junkbotix/toy-rc-car-robot-platform/README.md

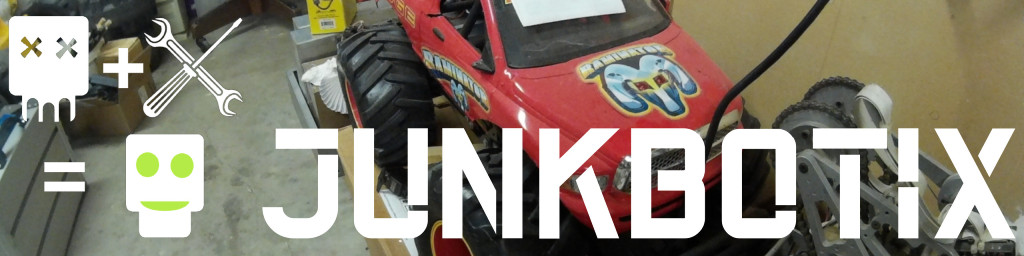
[picture p1: images/banner-1024px.jpg]
Junkbotix Banner


# A Low-Cost Toy RC Car Robot Platform

Check out the latest on this project and tutorial at the [Junkbotix Channel](https://www.youtube.com/channel/UCNxQ47xBEYjD-mey_lxj9Aw) on Youtube!

<br>

## Mechanical

* [Steering](./steering)
* [Notes](./notes)

<br>

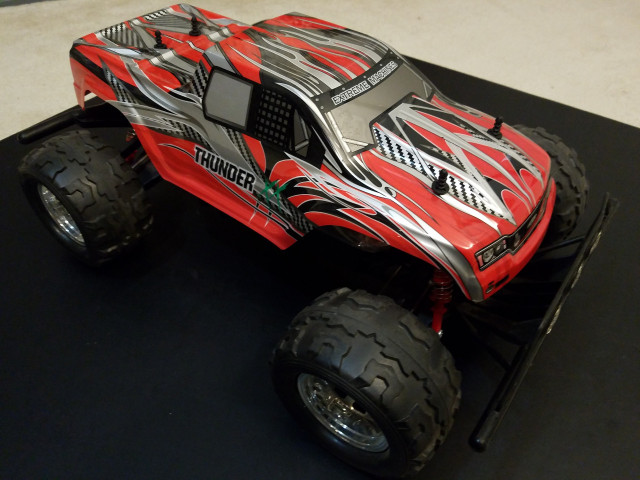
[picture p2: images/vehicle-640px.jpg]
Vehicle
 

## Platform / Deck

* [Fabrication](./platform-deck)
* [Completed Example](./platform-deck/completed)

<br>

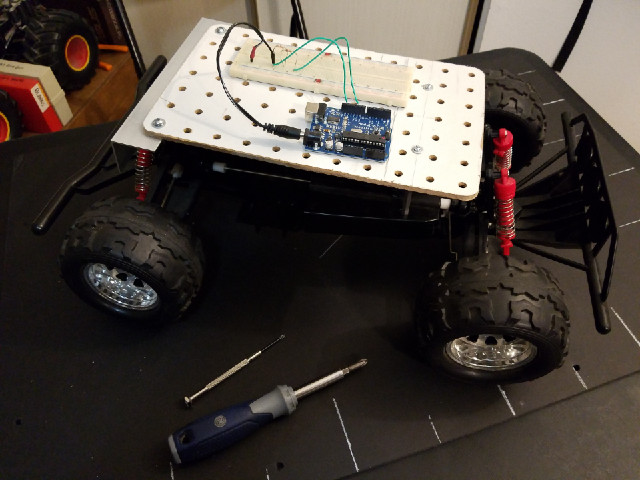
[picture p3: images/deck-640px.jpg]
 

<br>

## Electronics

* [Interfacing](./interfacing)
* [Sensors](./sensors)
* [Datasheets](./datasheets)

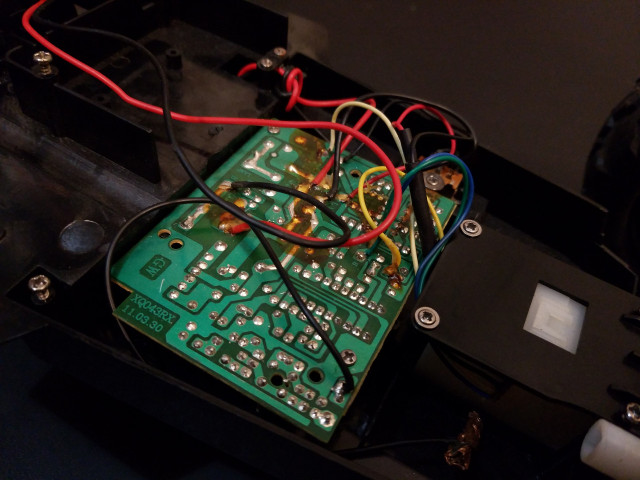
[picture p4: images/pcb-640px.jpg]
PCB


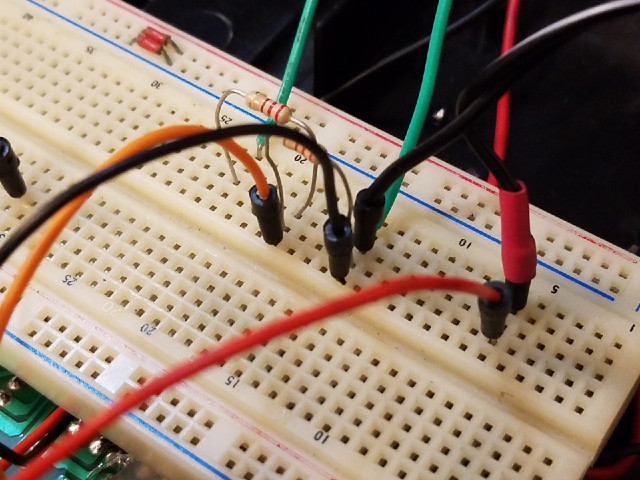
[picture p5: images/interface-640px.jpg]
Breadboard Interface


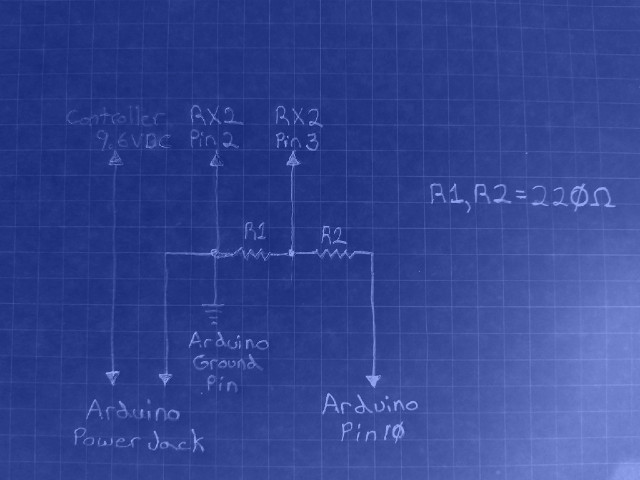
[picture p6: images/schematic-640px.jpg]
Schematic


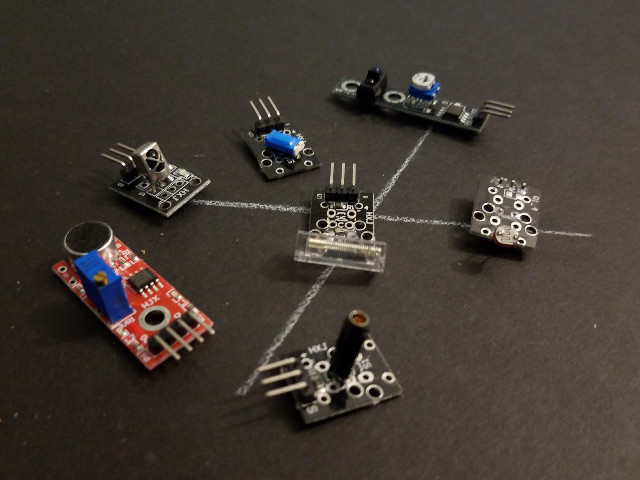
[picture p7: images/sensors-640px.jpg]
Sensors


<br>

## Software

* [Software](./software)
