junkbotix/toy-rc-car-robot-platform/software/README.md

# Software

Here you will find any and all software code, created by Junkbotix, that is related to this tutorial. Be sure to check back often for updates!

[Arduino](./arduino)

## Note

So far, only the Arduino Uno and Duemilanove have been tested and coded for. But just about anything should work (with the proper code written, of course). An interesting idea might involve using an ESP8266 or an ESP32, especially one with a camera board for computer vision experiments!
