junkbotix/toy-rc-car-robot-platform/steering/README.md

# Steering Actuator - A Curious Observation

The steering actuator on this vehicle is very curious in its design, which I have noted in the videos.

Mainly, because in addition to the wires for the motor that controls the actuator, it has four additional wires:

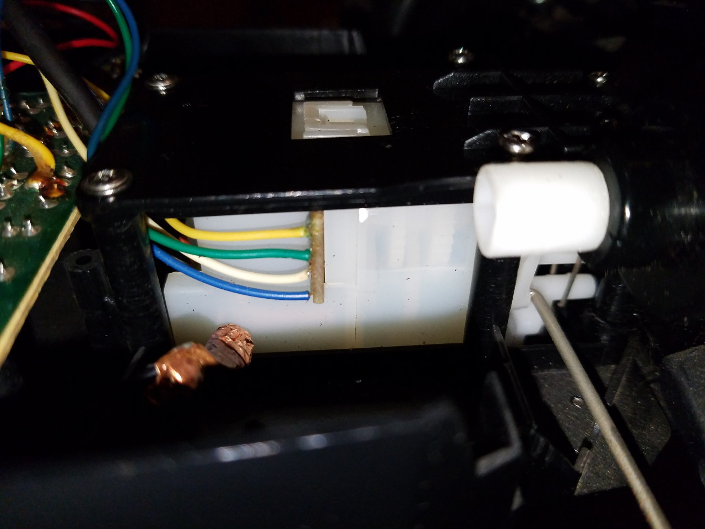
[picture p15: steering/images/actuator.jpg]
Steering Actuator
 

These wires appear to be connected in some manner to the steering actuator's h-bridge:

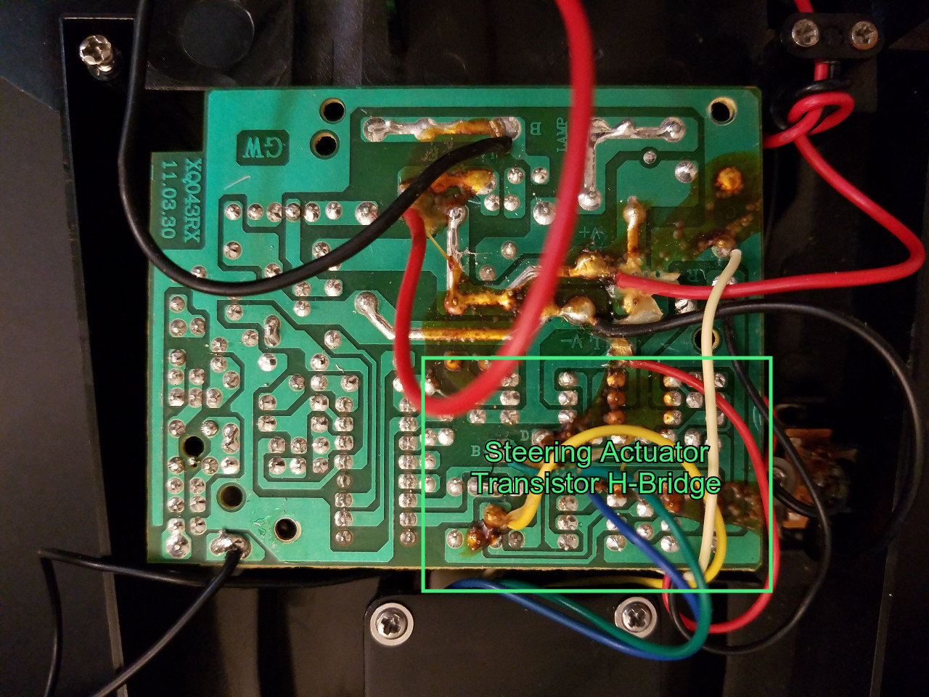
[picture p16: steering/images/pcb-bottom.jpg]
Controller Bottom
 
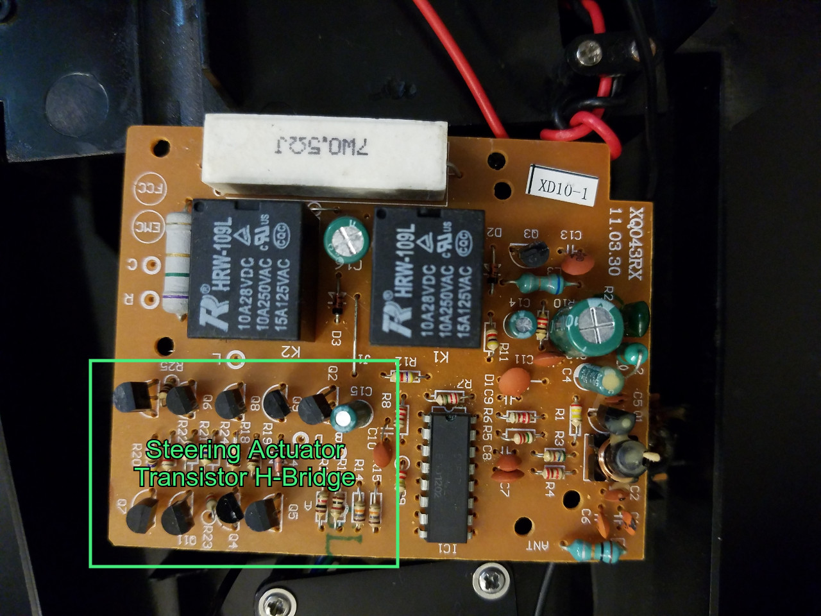
[picture p17: steering/images/pcb-top.jpg]
Controller Top
 

## What makes this strange?

The reason that this is so curious, is that the datasheet for the [SDRX2BD](../datasheets/controller) indicates that the IC only has outputs for left and right steering (pins 6 & 7), and the input pins (8 & 9) for disabling these functions are not hooked up on my car's controller:

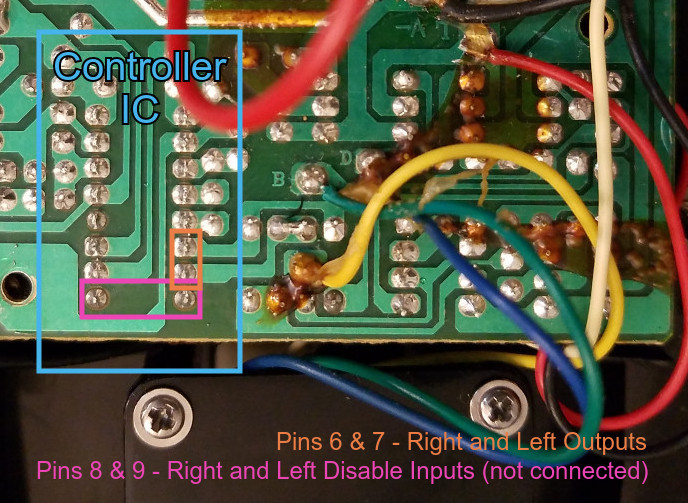
[picture p18: steering/images/pins.jpg]
SDRX2BD Pins


Furthermore, the implementation example schematic in the datasheet doesn't show anything about such functionality:

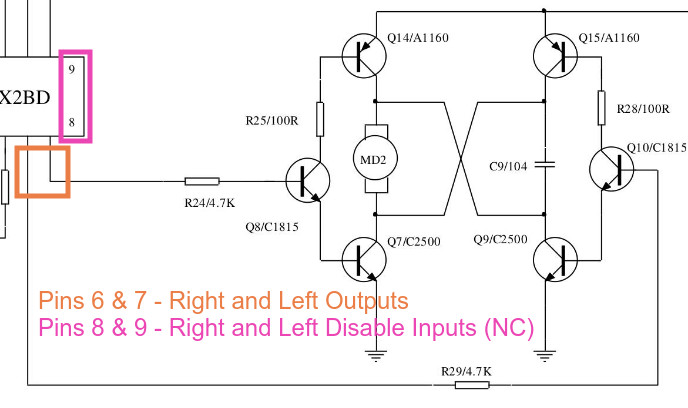
[picture p19: steering/images/schematic.jpg]
Example


As a final note, I have never seen any other toy RC vehicle that used this chipset (the TX2-RX2 and clones) have any kind of connections to the steering actuator other than directly to the motor - in other words, usually just two wires, instead of the "2+4" arrangement we see here.

## My analysis and thoughts

My best guess is that these wires serve in some manner to inhibit or "limit" the h-bridge output, perhaps to prevent it from drawing too much current, or maybe to automatically center it, or something of that nature.

Until I can reverse-engineer a schematic for that section of the controller board (not a trivial task), it may remain a mystery. Further testing of direct control may reveal additional clues, too.

## More thoughts

After doing the fixes to the wiring, adding a battery, and turning it on, I noticed that the vehicle automatically "recentered" the front wheels. I believe this is actually the purpose of the additional wires, a kind of primitive servomechanism system to keep the car going straight when the steering actuator isn't active (being steered left or right). It might be that due to the size of the vehicle (larger than many or most TX2/RX2 chipset RC vehicles), it needed this kind of system to make it drivable at speed. Again, all of this is a guess without an actual schematic. I do find it a fascinating aspect of the platform!
