junkbotix/toy-rc-car-robot-platform/sensors/smartphone/README.md

# Using a Smartphone as a Sensor?

Well - really as a collection of sensors! I mean, how many sensors does a smartphone have? Tons!

But of particular interest for robotics use are the camera(s) and the GPS (and maybe the IMU, too!)...

* [Use Your Android Phone Sensors on the Arduino!](https://www.instructables.com/Use-your-android-phone-sensors-on-the-arduino-/)

Another great example of using a phone in such a manner is David Singleton's Neural Network RC Vehicle:

* [How I built a neural network controlled self-driving (RC) car!](https://blog.singleton.io/nnrccar/)
