junkbotix/toy-rc-car-robot-platform/platform-deck/completed/README.md

# A Completed Pegboard Example

These are photos of the pegboard deck built for the tutorial video series, on the Thunder XX chassis I used.

## Rear Bracket

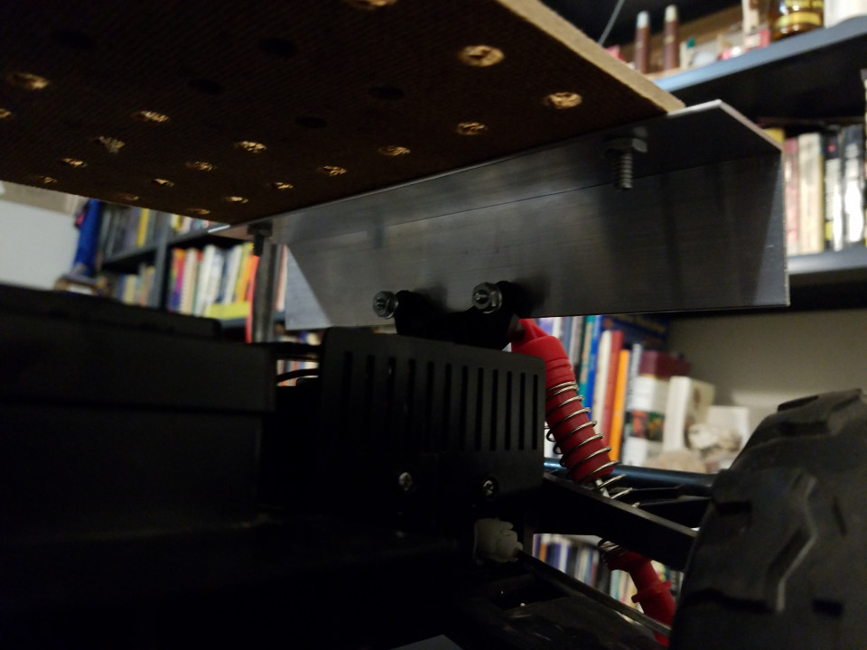
[picture p34: platform-deck/completed/images/rear-bracket-960px.jpg]
Rear Bracket


## Front Standoffs

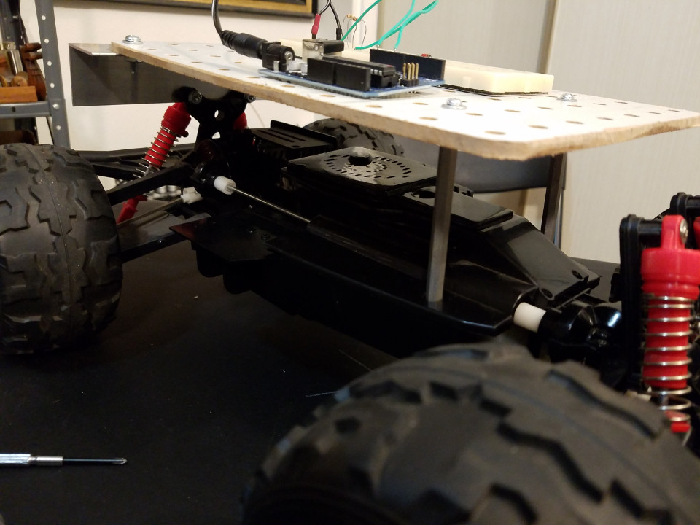
[picture p35: platform-deck/completed/images/front-standoffs-960px.jpg]
Front Standoffs


## Deck

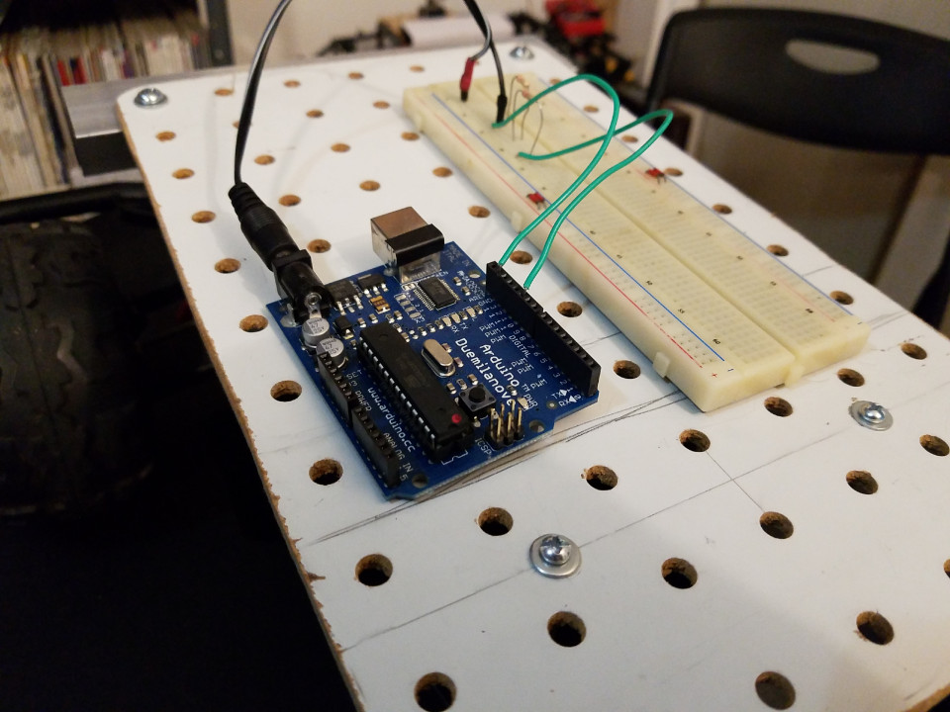
[picture p36: platform-deck/completed/images/deck-example-960px.jpg]
Deck


## Chassis and Deck

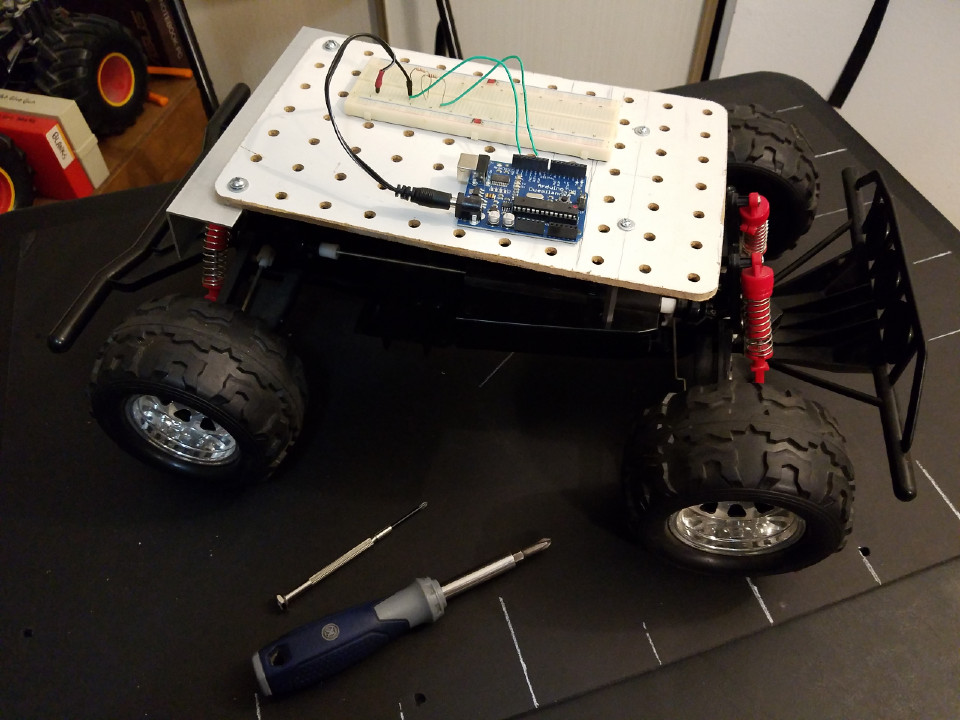
[picture p37: platform-deck/completed/images/chassis-deck-960px.jpg]
Chassis and Deck
