junkbotix/toy-rc-car-robot-platform/interfacing/thunder-xx/backlit-controller.jpg

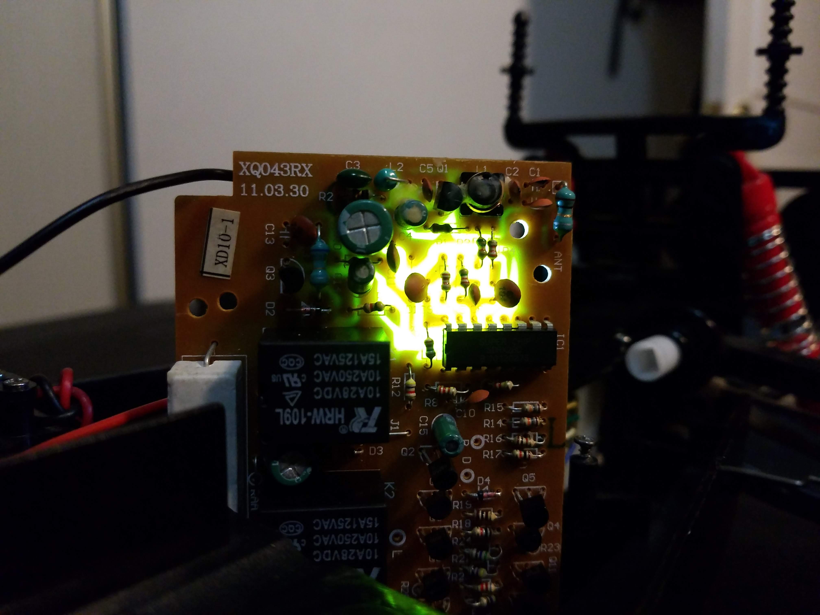
interfacing/thunder-xx/backlit-controller.jpg
