junkbotix/toy-rc-car-robot-platform/interfacing/thunder-xx/hand-drawn-schematic.jpg

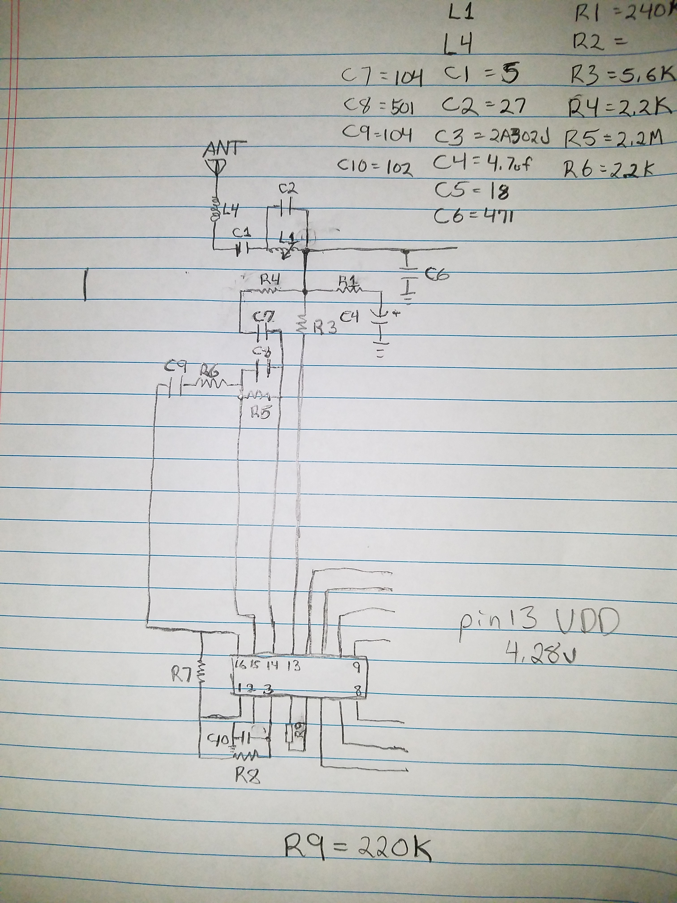
interfacing/thunder-xx/hand-drawn-schematic.jpg
