junkbotix/toy-rc-car-robot-platform/interfacing/thunder-xx/other-notes.jpg

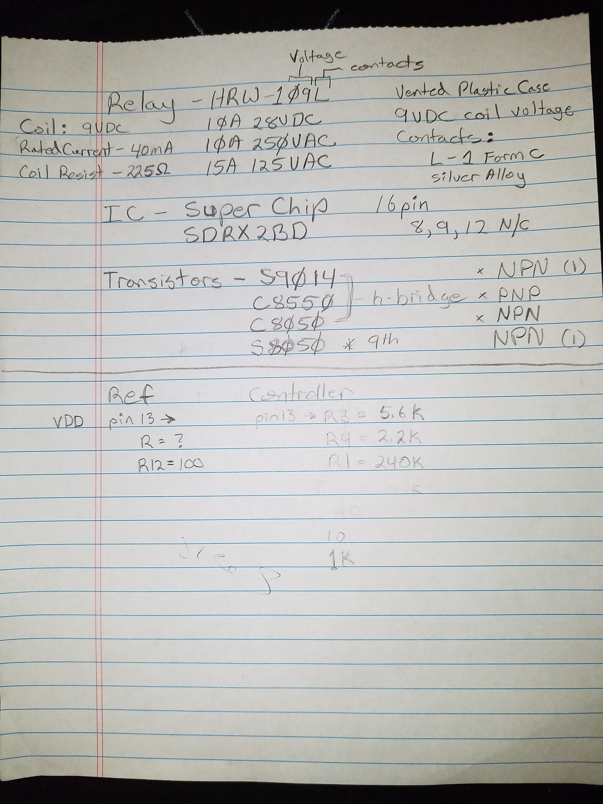
interfacing/thunder-xx/other-notes.jpg
