junkbotix/toy-rc-car-robot-platform/sensors/contact-sensors/images/microswitch-example-640px.jpg

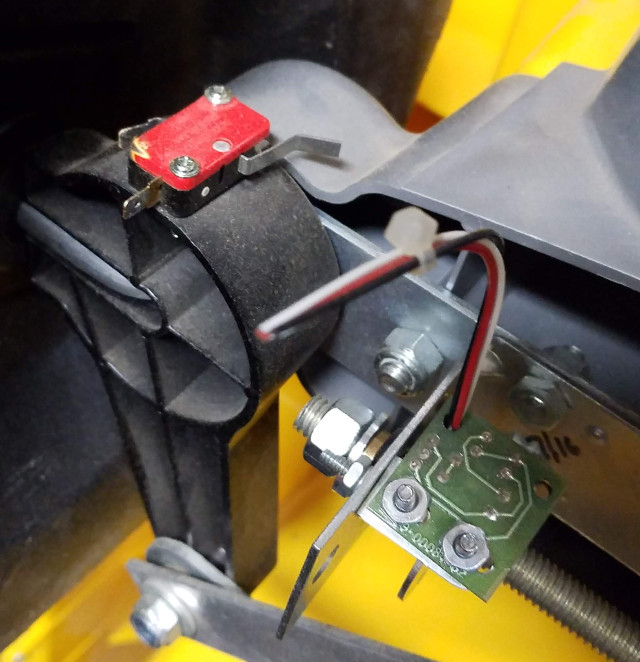
sensors/contact-sensors/images/microswitch-example-640px.jpg
