junkbotix/toy-rc-car-robot-platform/sensors/components/README.md

# Discrete Components

Individual components can be easily ordered from a variety of vendors, way too many to list unfortunately. I will however list some companies here I have had past good experiences with, along with some pictures of some useful discrete sensor components and what they can be used for.

<br>

## New Components

* Digikey - https://www.digikey.com/
* Mouser - https://www.mouser.com/
* Jameco - https://www.jameco.com/

Note: I understand these vendors are USA-centric, but they do ship internationally, and are probably the best way to get new and brand-name components at smaller quantities than you could get through many other sources. I may update this list in the future, if I get suggestions of other similar international sources, or as I find them.

<br>

## NOS (New-Old Stock) and Surplus Components

* All Electronics - https://www.allelectronics.com/
* Electronic Goldmine - https://www.goldmine-elec-products.com/
* Altronics - https://anatekinstruments.com/

Again, the above vendors are USA-centric, and from what I understand, surplus electronics sales tend to be a mostly American thing, as laws in other countries (ymmv) prohibit or severely limit such "recycling". Also, despite being "surplus" outlets, all of the above vendors also sell new components and other new items.

Finally, don't hesitate to look into discrete components from Amazon or Ebay...sometimes you can find interesting stuff there, too!

<br>

## Examples

### Photoresistors (aka LDR, CdS cells, etc)
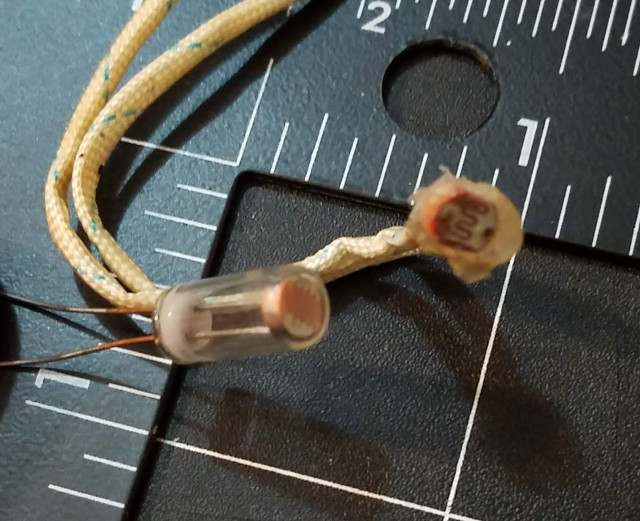
[picture p55: sensors/components/images/photoresistors-640px.jpg]
Photoresistors


### Phototransistors
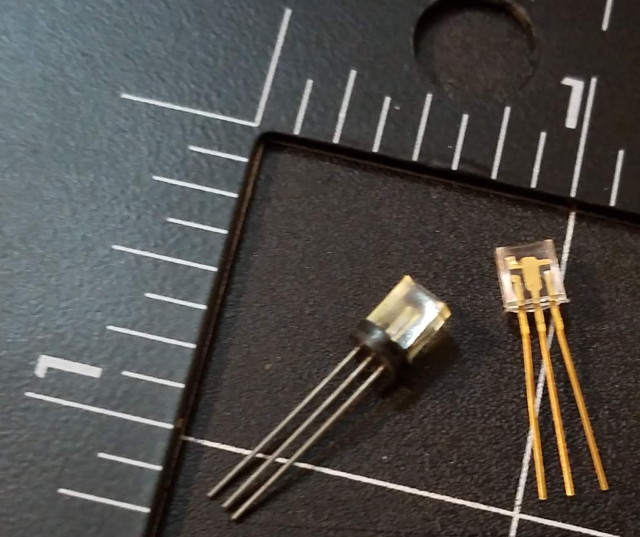
[picture p56: sensors/components/images/phototransistors-640px.jpg]
Phototransistors


### Slot Sensor
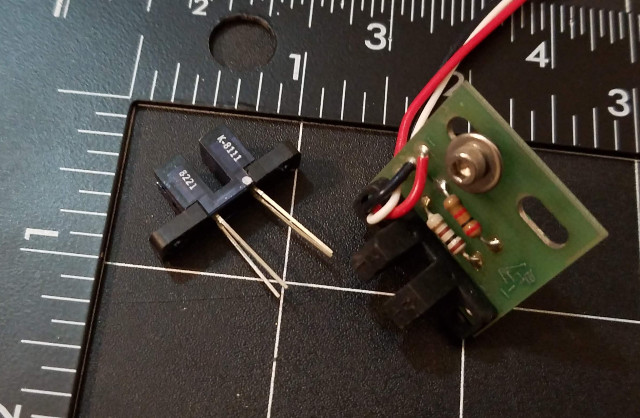
[picture p57: sensors/components/images/slot-sensors-640px.jpg]
Slot Sensor


### Thermistor
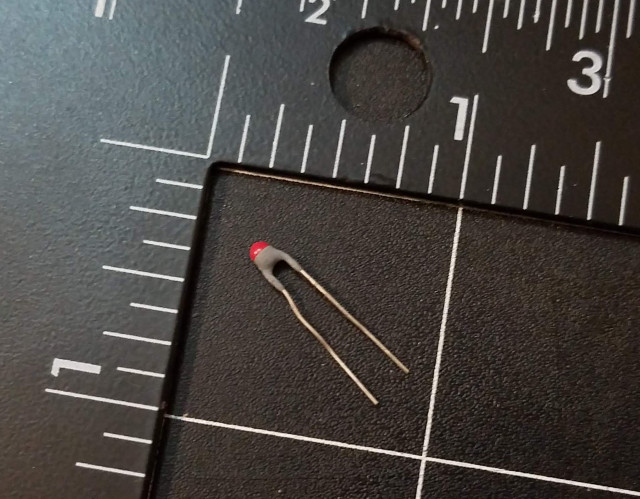
[picture p58: sensors/components/images/thermistor-640px.jpg]
Thermister


### Microswitch (Contact Sensor)
Microswitch

### Tilt Sensor (Ball-in-Cage)
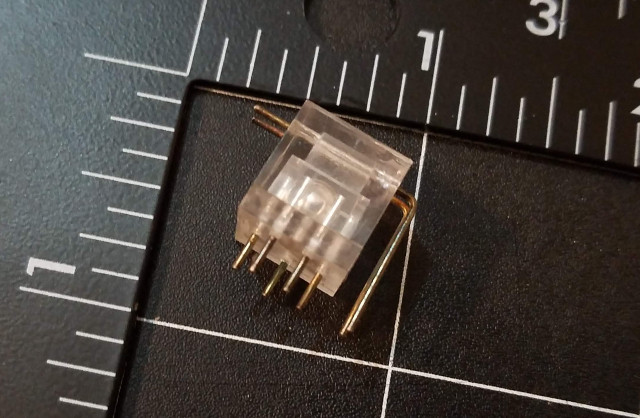
[picture p59: sensors/components/images/tilt-sensor-640px.jpg]
Tilt Sensor
