junkbotix/toy-rc-car-robot-platform/(commit log)

2020-12-10 added rc car relay photo and PDF datasheet
2020-12-11 added section on a curious steering actuator thing
2020-12-26 updates for signal injection, added arduino test code, photos, schematics, etc
2021-01-04 Added information and pictures for deck mounting adapters
2021-01-10 Updates to support Part 8 - Adding Sensors tutorial video
